0xDBFB7/psychic-probe/(list of files, drawings)

Other design files:
hardware/probe/probe.dsn
