0xDBFB7/psychic-probe/hardware/probe/probe.kicad_pcb

## KiCad design hardware/probe/probe.kicad_pcb (2019-01-19)

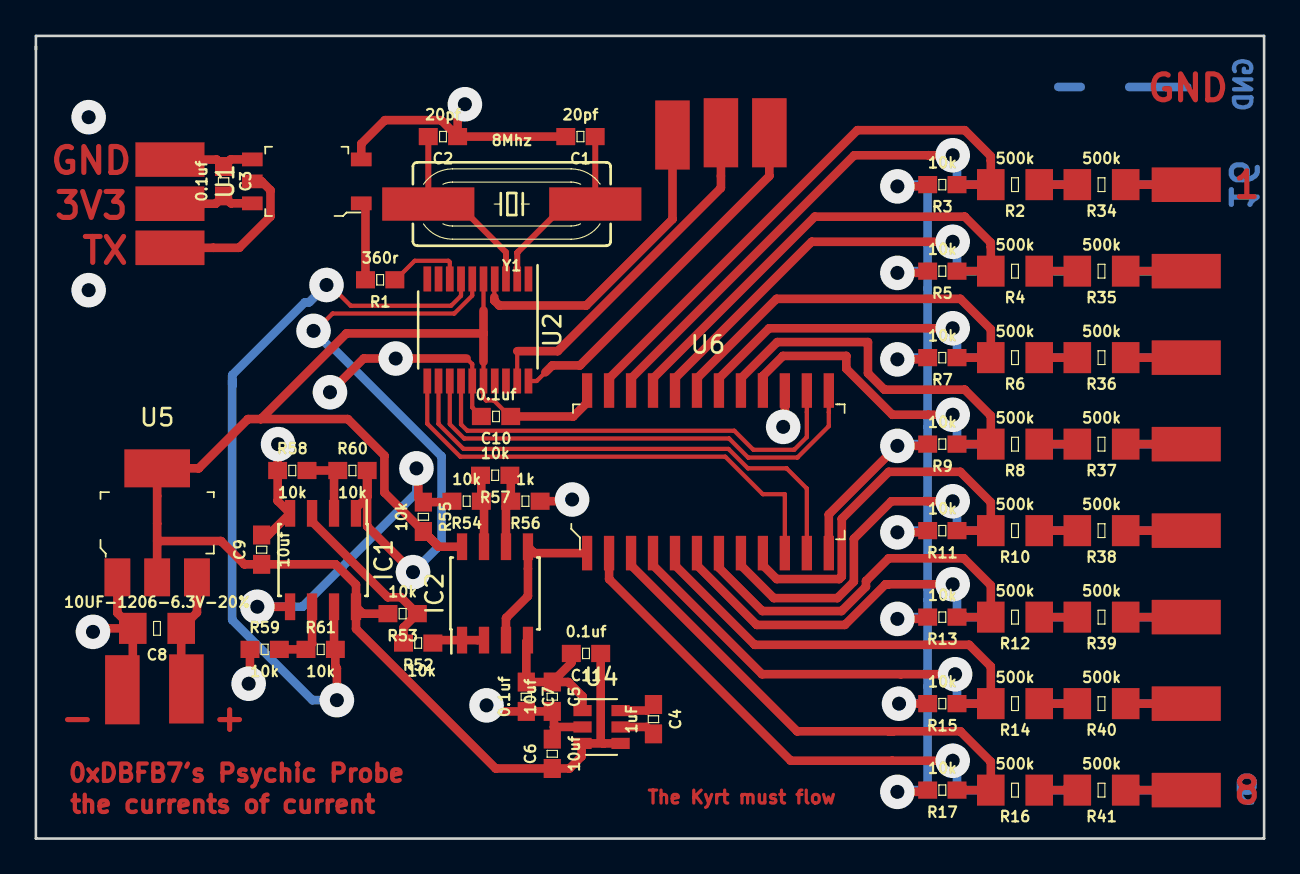
[picture p1: board probe.kicad_pcb from above]

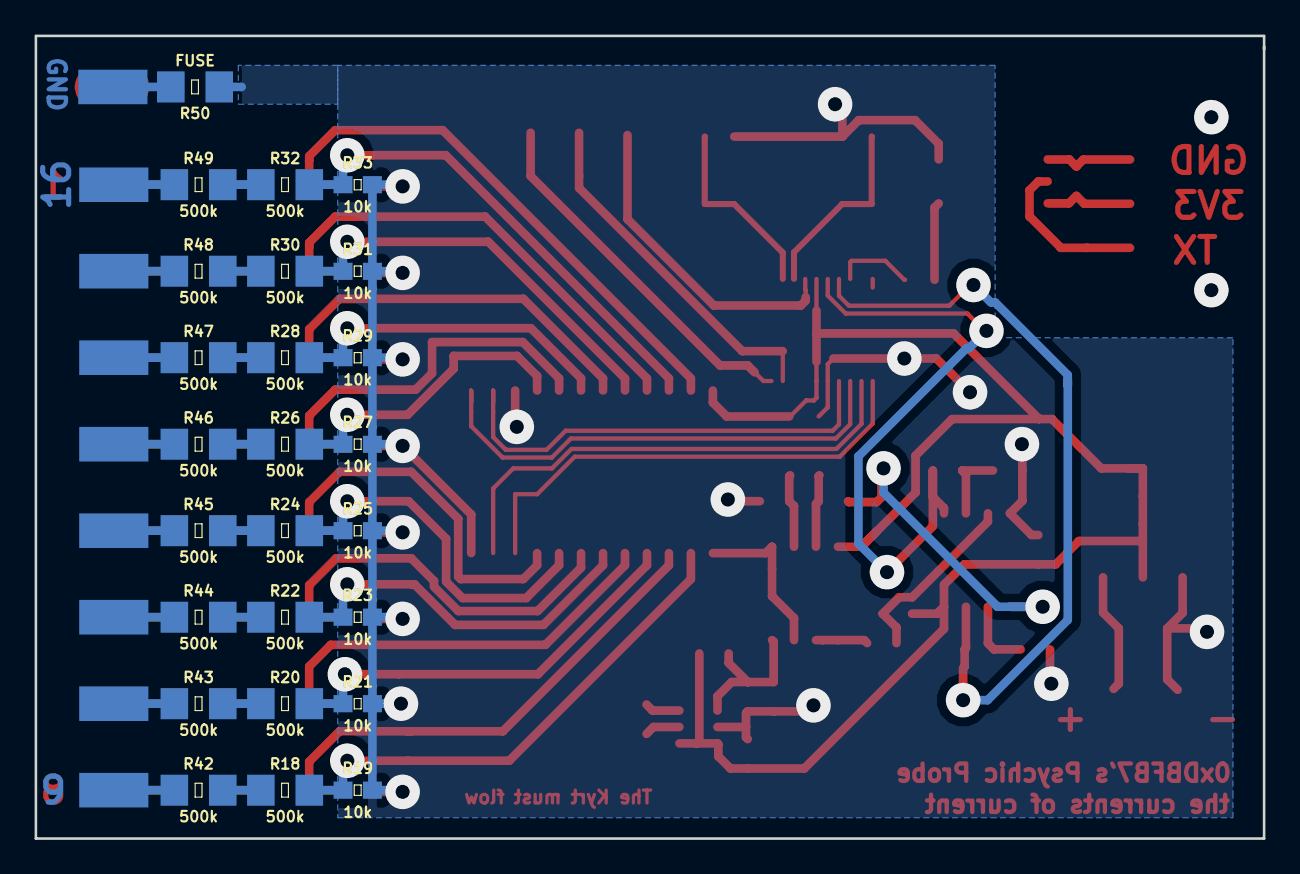
[picture p2: board probe.kicad_pcb from below]

Board: 2 copper layers, 71.0 x 46.4 mm, 104 parts (34 on the bottom side), 79 nets.

Parts:
C1, C2: 20pf; 0603
C3, C7, C10, C11: 0.1uf; 0603
C4: 1uF; 0603
C5, C6, C9: 10uf; 0603
C8: 10UF-1206-6.3V-20%; 1206
IC1: TLV9062IDR; SOIC-8_3.9x4.9mm_P1.27mm
IC2: AZ4580; SOIC-8_3.9x4.9mm_P1.27mm
J1, J18, J21, J22: ISOL_3v3; CAP_WIRE_CONNECTION
J2, J3, J4, J5, J6, J7, J8, J9, J10, J11, J12, J13, J14, J15, J16, J17: CONN_01; CAP_WIRE_CONNECTION
J19: ISOL_GND; CAP_WIRE_CONNECTION
J20: ISOL_OUTPUT; CAP_WIRE_CONNECTION
J23: BATT; CAP_WIRE_CONNECTION
J24, J25: GND; CAP_WIRE_CONNECTION
R1: 360r; 0603
R2, R4, R6, R8, R10, R12, R14, R16, R18, R20, R22, R24, R26, R28, R30, R32, R34, R35, R36, R37, R38, R39, R40, R41, R42, R43, R44, R45, R46, R47, R48, R49: 500k; 1206
R3, R5, R7, R9, R11, R13, R15, R17, R19, R21, R23, R25, R27, R29, R31, R33, R52, R53, R54, R55, R57, R58, R59, R60, R61: 10k; 0603
R50: FUSE; 1206
R56: 1k; 0603
U1: TLP2361; SOIC-6-5_W4.55mm
U2: STM32F030F4Px; TSSOP-20_4.4x6.5mm_P0.65mm
U4: LM2776; SOT-23-6
U5: AZ1117; SOT-223
U6: CD74HC4067M96; SOIC-24_W7.50mm
Y1: 8Mhz; HC49UP

Connections:
+3.3V: C6.1, C9.1, C10.1, C11.1, IC1.8, IC2.8, R53.2, R55.2, U2.5, U2.16, U4.3, U4.4, U5.2, U5.4, U6.24
-3V3: C5.1, C7.1, C11.2, IC2.4, U4.1
/BATT: C8.1, J23.1, U5.3
/Dividers/OUT1: R2.2, R3.1, U6.23
/Dividers/OUT2: R4.2, R5.1, U6.21
/Dividers/OUT3: R6.2, R7.1, U6.19
/Dividers/OUT4: R8.2, R9.1, U6.17
/Dividers/OUT5: R10.2, R11.1, U6.9
/Dividers/OUT6: R12.2, R13.1, U6.7
/Dividers/OUT7: R14.2, R15.1, U6.5
/Dividers/OUT8: R16.2, R17.1, U6.3
/Dividers/OUT9: R18.2, R19.1, U6.2
/Dividers/OUT10: R20.2, R21.1, U6.4
/Dividers/OUT11: R22.2, R23.1, U6.6
/Dividers/OUT12: R24.2, R25.1, U6.8
/Dividers/OUT13: R26.2, R27.1, U6.16
/Dividers/OUT14: R28.2, R29.1, U6.18
/Dividers/OUT15: R30.2, R31.1, U6.20
/Dividers/OUT16: R32.2, R33.1, U6.22
/ISOL_3v3: C3.2, J18.1, U1.6
/ISOL_GND: C3.1, J19.1, U1.4
/ISOL_OUTPUT: J20.1, U1.5
/MUX_OUT: IC2.3, IC2.5, U6.1
/RESET: J1.1, U2.4
/S0: U2.11, U6.10
/S1: U2.12, U6.11
/S2: U2.13, U6.13
/S3: U2.14, U6.14
/SHIFTED_x1: IC1.1, R60.2, U2.6
/SHIFTED_x10: IC1.7, R61.2, U2.7
/SWCLK: J22.1, U2.20
/SWDIO: J21.1, U2.19
/UART_TX: R1.1, U2.8
GND: C1.2, C2.1, C5.2, C6.2, C7.2, C8.2, C9.2, C10.2, IC1.4, J24.1, R3.2, R5.2, R7.2, R9.2, R11.2, R13.2, R15.2, R17.2, R19.2, R21.2, R23.2, R25.2, R27.2, R29.2, R31.2, R33.2, R50.1, R56.1, R58.1, R59.1, U1.3, U2.15, U4.2, U5.1, U6.12, U6.15
unnamed: C1.1, U2.2, Y1.1
unnamed: C2.2, U2.3, Y1.2
unnamed: C4.1, U4.6
unnamed: C4.2, U4.5
unnamed: IC1.2, R58.2, R60.1
unnamed: IC1.3, R52.2, R53.1
unnamed: IC1.5, R54.2, R55.1
unnamed: IC1.6, R59.2, R61.1
unnamed: IC2.1, IC2.2, R52.1
unnamed: IC2.6, R56.2, R57.1
unnamed: IC2.7, R54.1, R57.2
unnamed: J2.1, R34.1
unnamed: J3.1, R35.1
unnamed: J4.1, R36.1
unnamed: J5.1, R37.1
unnamed: J6.1, R38.1
unnamed: J7.1, R39.1
unnamed: J8.1, R40.1
unnamed: J9.1, R41.1
unnamed: J10.1, R42.1
unnamed: J11.1, R43.1
unnamed: J12.1, R44.1
unnamed: J13.1, R45.1
unnamed: J14.1, R46.1
unnamed: J15.1, R47.1
unnamed: J16.1, R48.1
unnamed: J17.1, R49.1
unnamed: J25.1, R50.2
unnamed: R1.2, U1.1
unnamed: R2.1, R34.2
unnamed: R10.1, R38.2
unnamed: R12.1, R39.2
unnamed: R14.1, R40.2
unnamed: R16.1, R41.2
unnamed: R18.1, R42.2
unnamed: R20.1, R43.2
unnamed: R22.1, R44.2
unnamed: R24.1, R45.2
unnamed: R26.1, R46.2
unnamed: R28.1, R47.2
unnamed: R30.1, R48.2
unnamed: R32.1, R49.2
unnamed: R4.1, R35.2
unnamed: R6.1, R36.2
unnamed: R8.1, R37.2
