0xDBFB7/psychic-probe/firmware/probe_firmware/Src/main.c

/**
  ******************************************************************************
  * @file           : main.c
  * @brief          : Main program body
  ******************************************************************************
  ** This notice applies to any and all portions of this file
  * that are not between comment pairs USER CODE BEGIN and
  * USER CODE END. Other portions of this file, whether
  * inserted by the user or by software development tools
  * are owned by their respective copyright owners.
  *
  * COPYRIGHT(c) 2019 STMicroelectronics
  *
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
  ******************************************************************************
  */
/* Includes ------------------------------------------------------------------*/
#include "main.h"
#include "stm32f0xx_hal.h"

/* USER CODE BEGIN Includes */
#include "tim_defines.h"

/* USER CODE END Includes */

ADC_HandleTypeDef hadc;

TIM_HandleTypeDef htim17;

UART_HandleTypeDef huart1;

/* USER CODE BEGIN PV */


#ifdef __GNUC__
#define PUTCHAR_PROTOTYPE int __io_putchar(int ch)
#else
#define PUTCHAR_PROTOTYPE int fputc(int ch, FILE *f)
#endif /* __GNUC__ */

PUTCHAR_PROTOTYPE
{
HAL_UART_Transmit(&huart1, (uint8_t *)&ch, 1, 0xFFFF);

return ch;
}
/////////////////////////////////////////////////
//Settings


#define CHANNELS 16
#define ID 1 //must be < 256 and > 0 or else line termination will break
            // A maximum of 4080 channels!

#define SCALE_THRESHOLD 150

/////////////////////////////////////////////////
//Board calibration factors
/////////////////////////////////////////////////
#define PACKET_LENGTH (CHANNELS*2)+1+1+4 //channels + checksum + id + terminator
#define ID_INDEX (CHANNELS*2)+1
#define CHECKSUM_INDEX ID_INDEX+1
#define TERMINATOR_INDEX_1 CHECKSUM_INDEX+1
#define TERMINATOR_INDEX_2 CHECKSUM_INDEX+2
#define TERMINATOR_INDEX_3 CHECKSUM_INDEX+3
uint8_t tx_buffer[PACKET_LENGTH];
uint16_t channel_values[CHANNELS][2];//buffer1/2, channel number, ADC input x1/x10
float channel_calibration_factors[16];

uint8_t current_ADC_channel = 0; //0: x1, 1: x10
uint8_t current_input_buffer = 0;
uint8_t current_input_channel = 0;
uint8_t print_complete = 0;
uint8_t adc_complete = 0;

uint8_t channel_lookup_table[16] = {8,10,12,14,0,2,4,6,7,5,3,1,15,13,11,9};
uint8_t chan = 0;
/////////////////////////////////////////////////


/* USER CODE END PV */

void SystemClock_Config(void);
static void MX_GPIO_Init(void);
static void MX_ADC_Init(void);
static void MX_USART1_UART_Init(void);
static void MX_TIM17_Init(void);

/* USER CODE BEGIN PFP */
void wait_cycles(uint32_t cycles){ //0.19 us per cycle
  volatile int cycle_counter = 0;
  for(cycle_counter = 0;cycle_counter<cycles;cycle_counter++){
  }
}

void switch_adc_channel(uint32_t channel){
  HAL_ADC_DeInit(&hadc);
  MX_ADC_Init();
  ADC_ChannelConfTypeDef sConfig;
  sConfig.Channel = channel;
  sConfig.Rank = ADC_RANK_CHANNEL_NUMBER;
  sConfig.SamplingTime = ADC_SAMPLETIME_1CYCLE_5;
  if (HAL_ADC_ConfigChannel(&hadc, &sConfig) != HAL_OK)
  {
    _Error_Handler(__FILE__, __LINE__);
  }
}
//
// //on the other side
void unsigned_to_buffer(uint16_t input,uint8_t index){
  tx_buffer[index] = input & 0xff;
  tx_buffer[index+1] = (input >> 8);
}

uint8_t chksum8(const uint8_t *buff, size_t len){
    unsigned int sum;
    for ( sum = 0 ; len != 0 ; len-- )
        sum += *(buff++);
    return (uint8_t)sum;
}

void faster_pin_write(GPIO_TypeDef* GPIOx, uint16_t GPIO_Pin, GPIO_PinState PinState)
{

  if (PinState != GPIO_PIN_RESET)
  {
    GPIOx->BSRR = (uint32_t)GPIO_Pin;
  }
  else
  {
    GPIOx->BRR = (uint32_t)GPIO_Pin;
  }
}


void select_mux_channel(uint8_t address){
    //ah darn! Why didn't I make the channels zero-indexed on the silkscreen?
    //That was tremendously stupid!
    //Let's let the convention be that all channel numbers are zero-indexed until they're graphed.
    uint8_t mux_channel = channel_lookup_table[address];
    faster_pin_write(S0_GPIO_Port, S0_Pin,(mux_channel >> 0) & 1U);
    faster_pin_write(S1_GPIO_Port, S1_Pin,(mux_channel >> 1) & 1U);
    faster_pin_write(S2_GPIO_Port, S2_Pin,(mux_channel >> 3) & 1U);
    faster_pin_write(S3_GPIO_Port, S3_Pin,(mux_channel >> 2) & 1U);
}

/* USER CODE END PFP */

/* USER CODE BEGIN 0 */
/**
* @brief This function handles ADC interrupt.
*/
// void HAL_ADC_ConvCpltCallback(ADC_HandleTypeDef* AdcHandle)
// {
//   //chan=!chan;
//   AdcHandle->Instance->DR;
// }
//

/* USER CODE END 0 */

/**
  * @brief  The application entry point.
  *
  * @retval None
  */
int main(void)
{
  /* MCU Configuration----------------------------------------------------------*/

  /* Reset of all peripherals, Initializes the Flash interface and the Systick. */
  HAL_Init();

  /* Configure the system clock */
  SystemClock_Config();

  /* Initialize all configured peripherals */
  MX_GPIO_Init();
  MX_ADC_Init();
  MX_USART1_UART_Init();
  MX_TIM17_Init();
  /* Infinite loop */
  /* USER CODE BEGIN WHILE */
  //
  //switch_adc_channel(ADC_CHANNEL_0);
  //HAL_ADC_Start(&hadc);
  // HAL_NVIC_SetPriority(ADC1_IRQn, 0, 0);
  // HAL_NVIC_EnableIRQ(ADC1_IRQn);
  //HAL_ADC_Start_IT(&hadc);

  // switch_adc_channel(ADC_CHANNEL_0);
  //HAL_NVIC_SetPriority(ADC1_IRQn, 0, 0);
  //HAL_NVIC_EnableIRQ(ADC1_IRQn);
  //select_mux_channel(current_input_channel);
  HAL_ADC_Start(&hadc);
  TIM17->CR1 |= TIM_CR1_CEN;

  while (1){

    // //HAL_IWDG_Refresh(&hiwdg);

    for(int i = 0; i < 1 ; i++){
      for(int t = 0; t < PACKET_LENGTH; t++){
        tx_buffer[t] = 0;
      }

      switch_adc_channel(ADC_CHANNEL_0);
      HAL_ADC_Start(&hadc);
      for(int channel_number = 0; channel_number < CHANNELS; channel_number++){
        //this section must not take more than ~30 clock cycles.
        select_mux_channel(channel_number);

        //x1
        while(HAL_IS_BIT_CLR(((&hadc)->Instance->ISR), ADC_FLAG_EOS));
        //EOS = End of sample
        channel_values[channel_number][0] = (&hadc)->Instance->DR;
      }

      switch_adc_channel(ADC_CHANNEL_1);
      HAL_ADC_Start(&hadc);
      for(int channel_number = 0; channel_number < CHANNELS; channel_number++){
        //this section must not take more than ~30 clock cycles.
        select_mux_channel(channel_number);

        //x10
        while(HAL_IS_BIT_CLR(((&hadc)->Instance->ISR), ADC_FLAG_EOS));
        //EOS = End of sample
        channel_values[channel_number][1] = (&hadc)->Instance->DR;
      }

      //
      // //HAL_ADC_Stop(&hadc);
      //printf("\r\n%i,%i\r\n",channel_values[0][0],channel_values[0][1] );
      for(int channel_number = 0; channel_number < CHANNELS; channel_number++){
        //threshold x1 to check if we need to switch to x10
        if(channel_values[channel_number][1] > SCALE_THRESHOLD && channel_values[channel_number][1] < (4096-SCALE_THRESHOLD)){
          unsigned_to_buffer(channel_values[channel_number][1],channel_number*2);
          //set the 7th bit of the high byte to 1.
          tx_buffer[(channel_number*2)+1] |= 1UL << 6;
        }
        else{
          unsigned_to_buffer(channel_values[channel_number][0],channel_number*2);
        }
      }

      tx_buffer[CHECKSUM_INDEX] = chksum8(tx_buffer,CHECKSUM_INDEX);
      tx_buffer[TERMINATOR_INDEX_1] = 0xff;
      tx_buffer[TERMINATOR_INDEX_2] = 0x00;
      tx_buffer[TERMINATOR_INDEX_3] = 0xff;
      //wait for previous transmission to complete, then TX
      // TIM17->CNT = 0;

      //debug messages
      // for(int i =0 ; i < PACKET_LENGTH; i++){
      //   printf("%i,",tx_buffer[i]);
      // }
      // printf("\r\n");

      HAL_UART_Transmit(&huart1, (uint8_t *)&tx_buffer,PACKET_LENGTH,100);
      // printf("\r\n%i\r\n",TIM17->CNT);
    }

    // tx_buffer[INDEX_CHECKSUM] = chksum8(tx_buffer,NUMBER_OF_VALUES);
    // printf(TIM17->CNT);
    //HAL_ADC_Stop_IT(&hadc);
    //printf("D\r\n");
    //while(HAL_UART_Transmit(&huart1, (uint8_t *)&tx_buffer, PACKET_BYTE_COUNT) == HAL_BUSY);

  /* USER CODE END WHILE */

  /* USER CODE BEGIN 3 */



  }
  /* USER CODE END 3 */

}

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
