0xDBFB7/psychic-probe/firmware/probe_firmware/probe_firmware.ioc

Mcu.UserName=STM32F030F4Px
PA0.GPIO_Label=IN_X1
PA0.Signal=ADC_IN0
PA1.GPIO_Label=IN_X10
PA1.Signal=ADC_IN1
PA13.Signal=SYS_SWDIO
PA14.Signal=SYS_SWCLK
PA2.Signal=USART1_TX
PA5.GPIO_Label=S0
PA5.Signal=GPIO_Output
PA6.GPIO_Label=S1
PA6.Signal=GPIO_Output
PA7.GPIO_Label=S2
PA7.Signal=GPIO_Output
PB1.GPIO_Label=S3
PB1.Signal=GPIO_Output
PF0-OSC_IN.Signal=RCC_OSC_IN
PF1-OSC_OUT.Signal=RCC_OSC_OUT
