0xDBFB7/psychic-probe/(commit log)

2018-12-16 I think I can simplify the amplifier a bit
    [file5C0EA928.sch, file5C1436B3.sch, probe.sch]
2018-12-18 Layout complete!
    [file5C0EA928.sch, file5C1436B3.sch, probe.dsn, probe.kicad_pcb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]
2019-01-19 Planning on renaming the firmware in STM32Cube
    [57705565.csv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]
2019-01-19 Optocoupler UART working
2019-01-19 Waiting for PollADC to complete takes way longer than an ADC cycle.
2019-01-19 ADC interrupt functional
2019-01-20 Working on a double buffer setup
    [_saved_probe.sch, test.csv]
2019-01-20 There's a substantial amount of jitter in the adc timing.
    [main.c]
2019-01-21 Why are 3 and 2 swapped on the schematic? Grrr
    [main.c]
2019-01-21 x10 and x1 were also swapped in code.
    [main.c]
2019-01-21 Feature complete, as nearly as I can tell
    [_saved_probe.sch, probe.sch]
