0xDBFB7/psychic-probe/(notices)

Notices in the files:
firmware/probe_firmware/Src/main.c:
(C) COPYRIGHT STMicroelectronics *****END OF FILE
